uurnd-com/HeliosRGB-PIHat/Variant_SingleChannel_Rev003/Design/Schematic_Helios_PIHat_Rev_0.3.0_2026-11-04.png

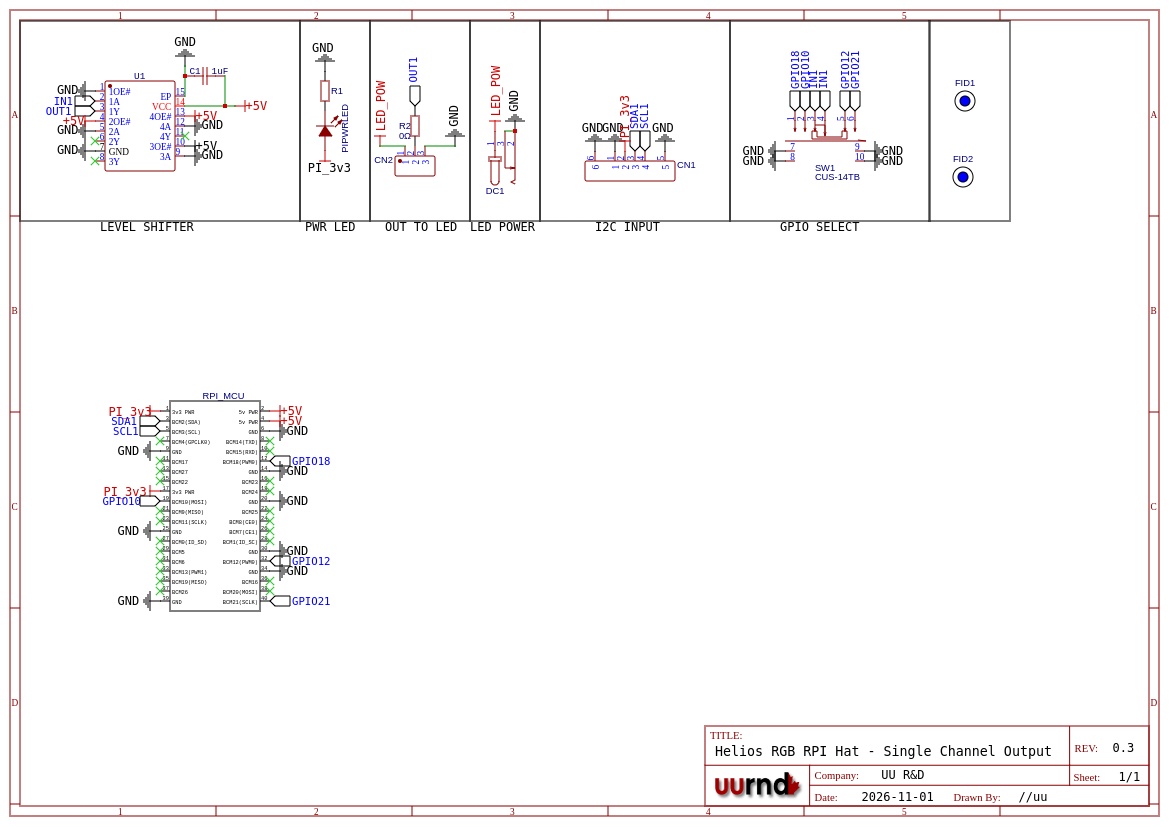
Variant_SingleChannel_Rev003/Design/Schematic_Helios_PIHat_Rev_0.3.0_2026-11-04.png
