uurnd-com/HeliosRGB-PIHat/Variant_SingleChannel_Rev003/Images/2dRenderBothSidesUnpop.png

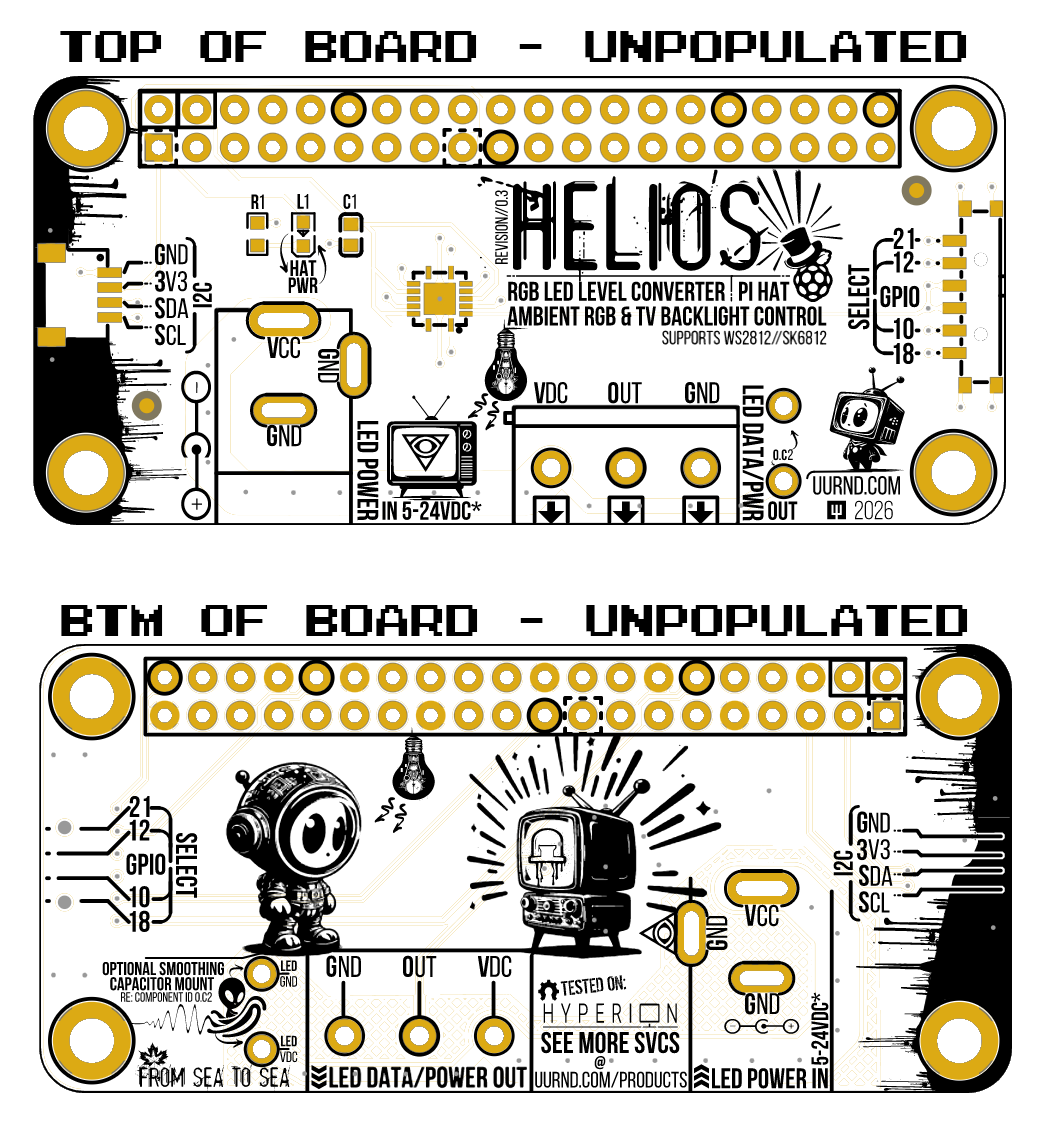
Variant_SingleChannel_Rev003/Images/2dRenderBothSidesUnpop.png
