uurnd-com/HeliosRGB-PIHat/Variant_SingleChannel_Rev003/Images/2dRenderUnpopBtm.png

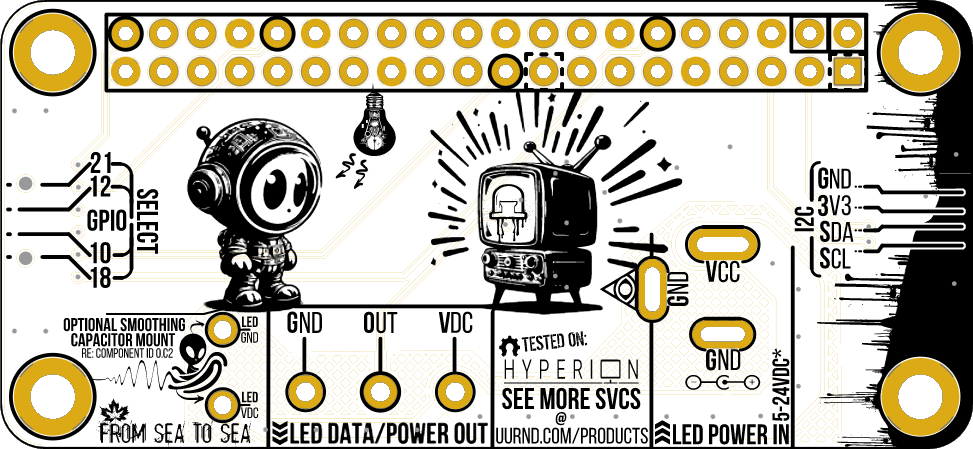
Variant_SingleChannel_Rev003/Images/2dRenderUnpopBtm.png
