uurnd-com/HeliosRGB-PIHat/Variant_SingleChannel_Rev003/Images/2dRenderUnpopTop.png

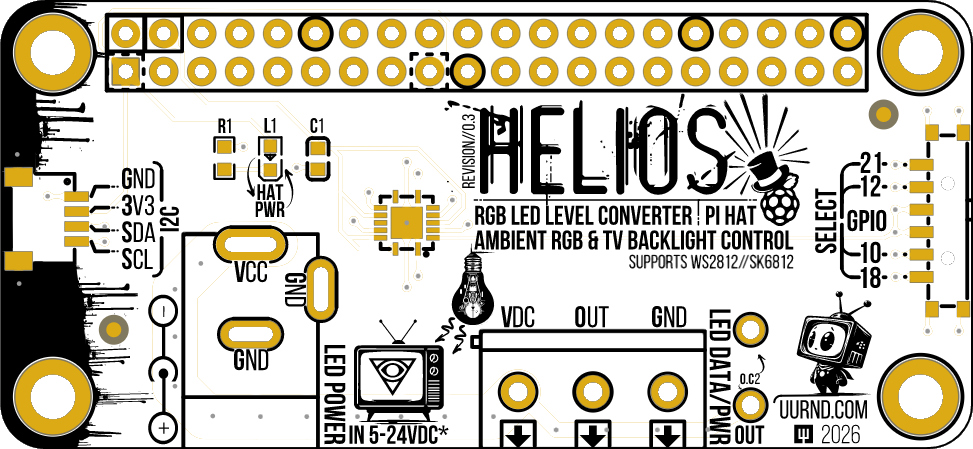
Variant_SingleChannel_Rev003/Images/2dRenderUnpopTop.png
