uurnd-com/HeliosRGB-PIHat/Variant_SingleChannel_Rev003/Images/helios-rgbled-pihat-whitebg.png

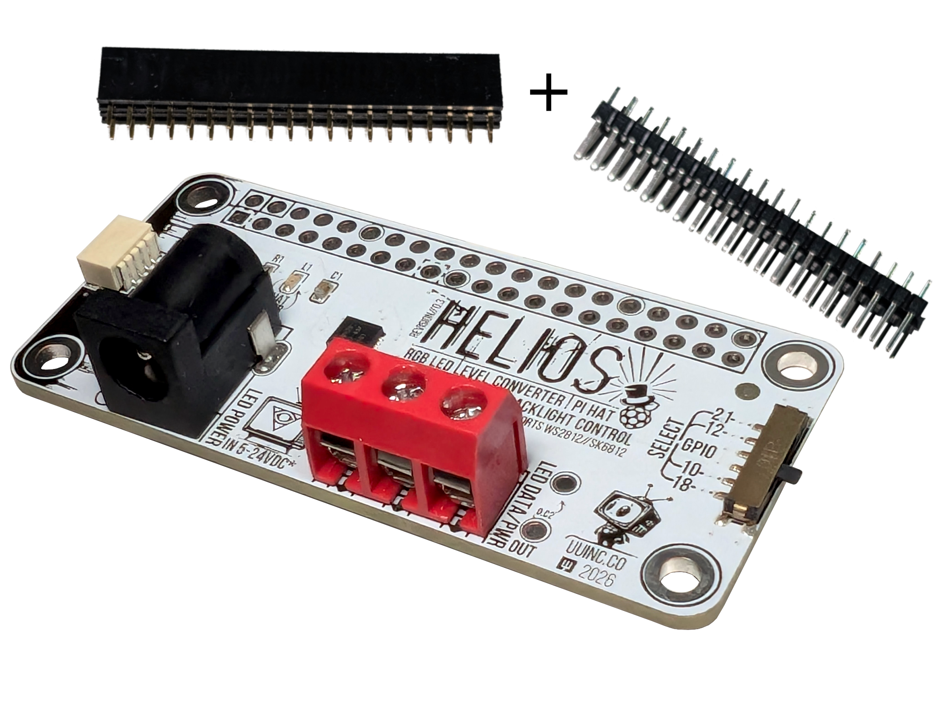
Variant_SingleChannel_Rev003/Images/helios-rgbled-pihat-whitebg.png
