uurnd-com/HeliosRGB-PIHat/Variant_SingleChannel_Rev003/Images/helios-rgbled-pihat.webp

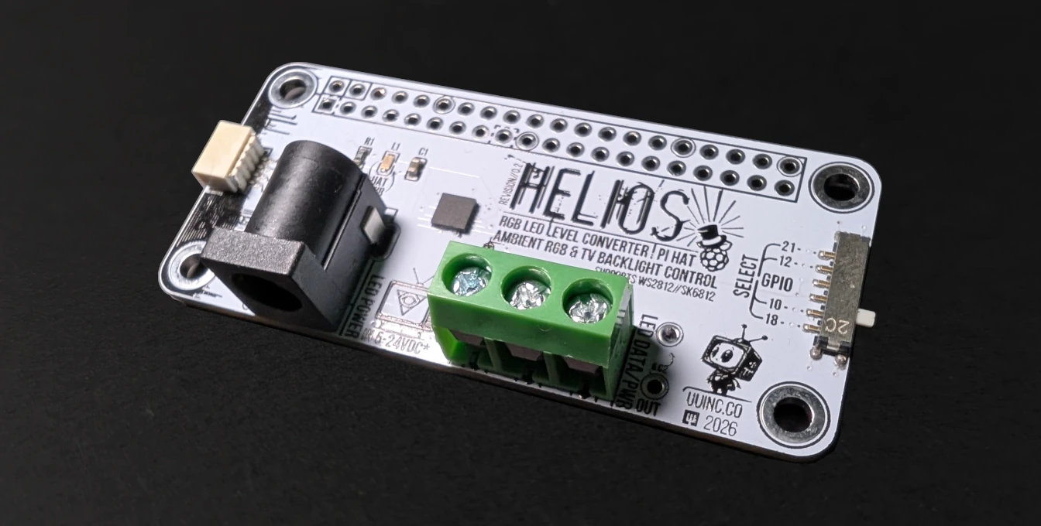
Variant_SingleChannel_Rev003/Images/helios-rgbled-pihat.webp
