uurnd-com/HeliosRGB-PIHat/Variant_SingleChannel_Rev003/3DModel/Parts/README.md

All Parts are rough-sized estimates only
