uurnd-com/HeliosRGB-PIHat/Variant_SingleChannel_Rev003/Manufacturing/BOM_Helios_PIHat_Rev_0.3.0_2026-11-04.csv

ID | Name | Designator | Footprint | Quantity | Manufacturer Part | Manufacturer | Supplier | Supplier Part | Price
1 | 1uF | 1 | C0603 | 1 | CL10A105KB8NNNC | SAMSUNG(三星) | LCSC | C15849 | 0.014
2 | TB003-500-P03BE | CN2 | UUCONN-TH_3P-P5.00_CUI_TB003-500-P03BE | 1 | TB003-500-P03BE | CUI | LCSC | C3819165 | 1.024
3 | CUS-14TB | SW1 | SW-SMD_NIDEC_CUS-14TB | 1 | CUS-14TB | NIDEC(尼得科) | LCSC | C2921741 | 0.969
4 | PJ-002AH | DC1 | DC-IN-TH_PJ-002AH | 1 | PJ-002AH | CUI | LCSC | C2961147 | 1.065
5 | 10kΩ | R1 | R0603 | 1 | 0603WAF1002T5E | UNI-ROYAL(厚声) | LCSC | C25804 | 0.002
6 | SM04B-SRSS-TB (LF)(SN) | CN1 | CONN-SMD_4P-P1.00_SM04B-SRSS-TB-LF-SN | 1 | SM04B-SRSS-TB(LF)(SN) | JST | LCSC | C160404 | 0.217
7 | KT-0603R | PIPWRLED | LED0603-RD | 1 | KT-0603R | KENTO | LCSC | C2286 | 0.008
8 | SN74AHCT125RGYR | U1 | VQFN-14_L3.5-W3.5-P0.50-BL-EP | 1 | SN74AHCT125RGYR | TI(德州仪器) | LCSC | C2675532 | 0.482
