uurnd-com/HeliosRGB-PIHat/Variant_SingleChannel_Rev003/3DModel/Cases/RPI4b_Helios_PiHatCase/RPI4_Helios_PiHatCase_Top.stl

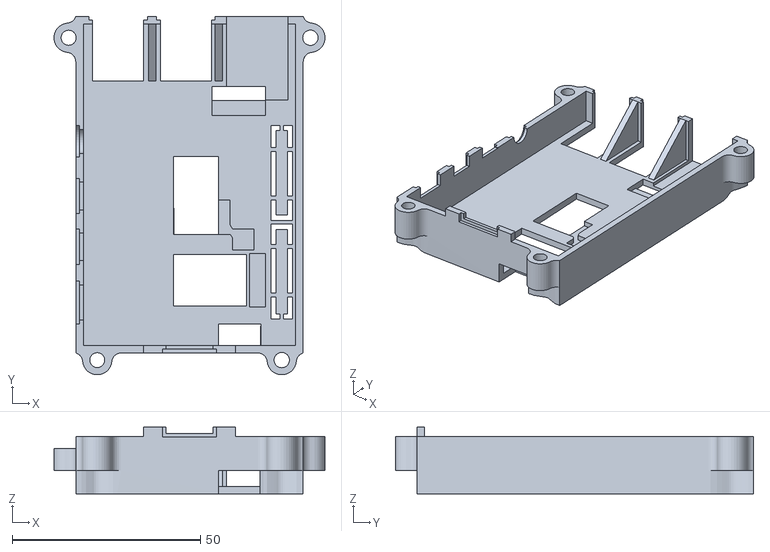
[picture p10: CAD file, 2026-11-12]
Variant_SingleChannel_Rev003/3DModel/Cases/RPI4b_Helios_PiHatCase/RPI4_Helios_PiHatCase_Top.stl
72.0 x 95.2 x 17.7
