uurnd-com/HeliosRGB-PIHat/Variant_SingleChannel_Rev003/3DModel/Cases/RPIZero_Helios_PiHatCase/HeliosPiZeroTop.stl

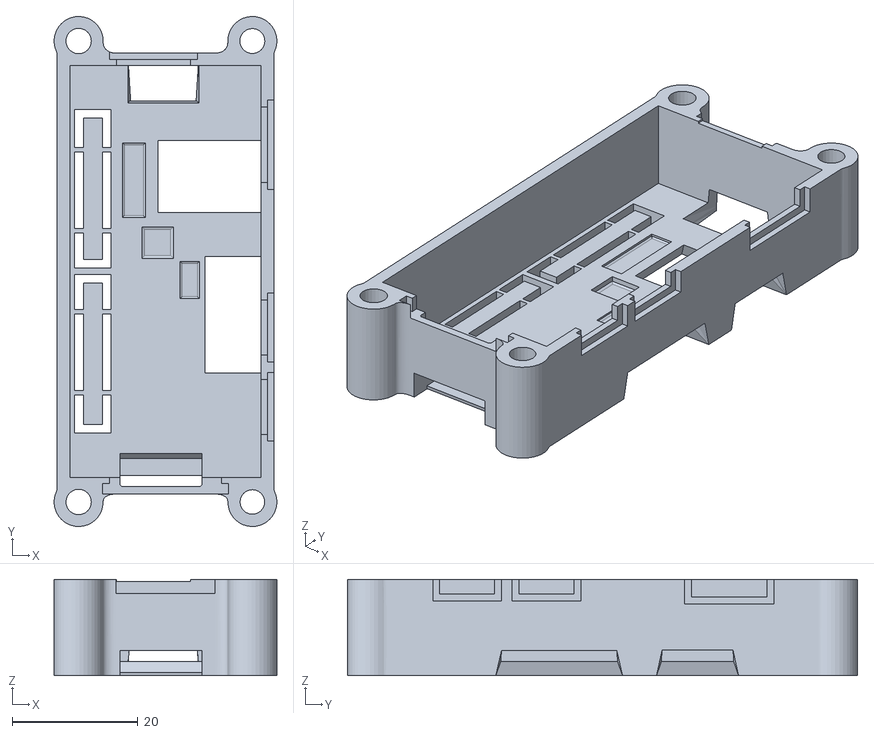
[picture p11: CAD file, 2026-11-12]
Variant_SingleChannel_Rev003/3DModel/Cases/RPIZero_Helios_PiHatCase/HeliosPiZeroTop.stl
35.4 x 81.0 x 15.3
