uurnd-com/HeliosRGB-PIHat/Variant_SingleChannel_Rev003/3DModel/MockupsAndLayouts/BoardModelPopulated/BoardModel_Populated.stl

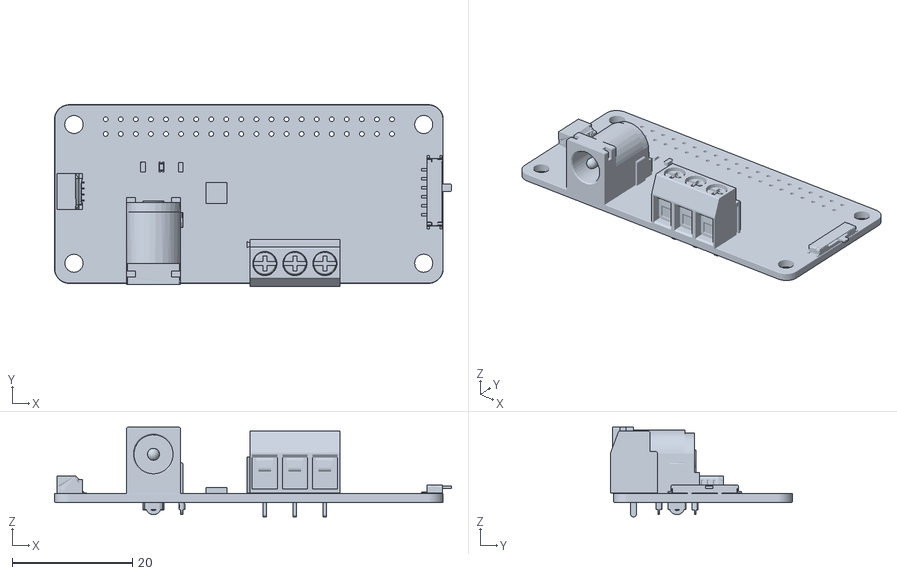
[picture p12: CAD file, 2026-11-05]
Variant_SingleChannel_Rev003/3DModel/MockupsAndLayouts/BoardModelPopulated/BoardModel_Populated.stl
66.1 x 30.3 x 14.9
