uurnd-com/HeliosRGB-PIHat/Variant_SingleChannel_Rev003/3DModel/MockupsAndLayouts/BoxModelUnpopulated/BoxModel_Unpopulated.stl

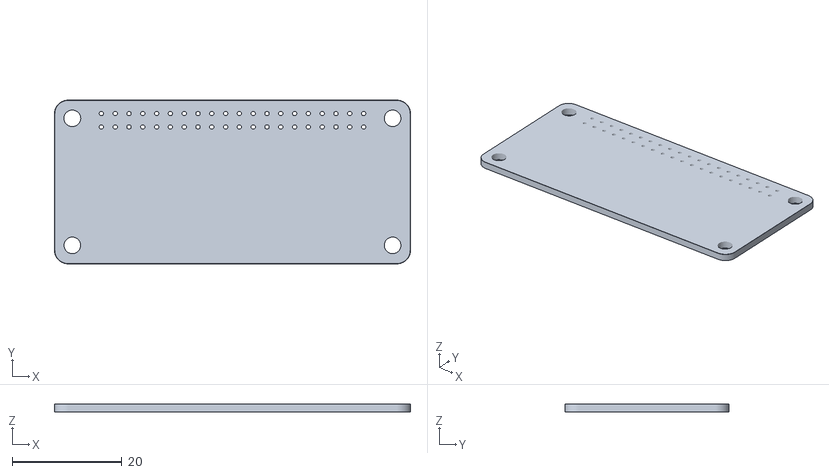
[picture p13: CAD file, 2026-11-05]
Variant_SingleChannel_Rev003/3DModel/MockupsAndLayouts/BoxModelUnpopulated/BoxModel_Unpopulated.stl
64.8 x 29.8 x 1.50
