uurnd-com/HeliosRGB-PIHat/Variant_SingleChannel_Rev003/3DModel/Parts/CUS-14TB/CUS-14TB.stl

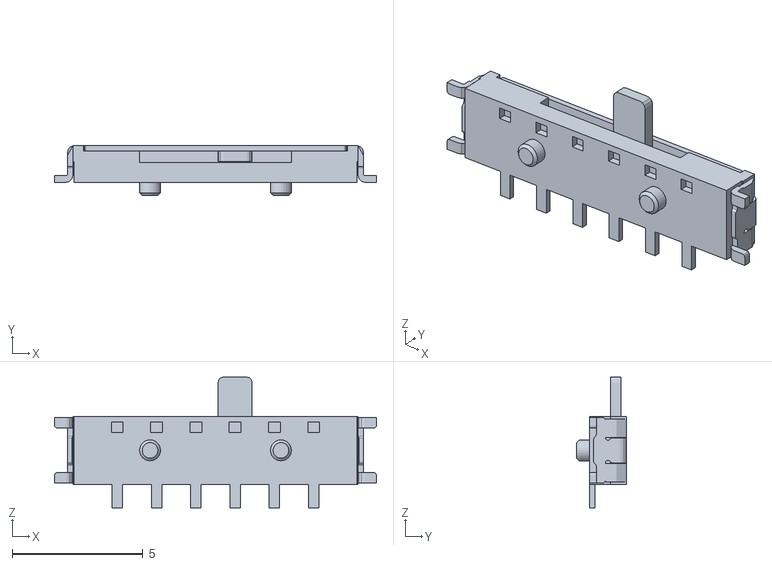
[picture p14: CAD file, 2026-01-15]
Variant_SingleChannel_Rev003/3DModel/Parts/CUS-14TB/CUS-14TB.stl
12.3 x 1.90 x 5.00
