uurnd-com/HeliosRGB-PIHat/Variant_SingleChannel_Rev003/3DModel/Parts/Passives/Passives.stl

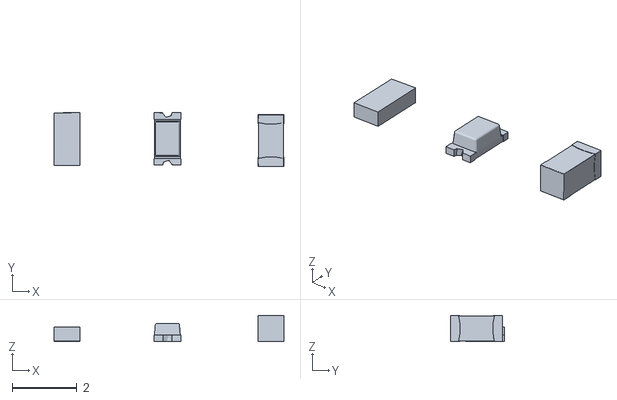
[picture p15: CAD file, 2026-11-05]
Variant_SingleChannel_Rev003/3DModel/Parts/Passives/Passives.stl
7.09 x 1.67 x 0.804
