uurnd-com/HeliosRGB-PIHat/Variant_SingleChannel_Rev003/3DModel/Parts/PJ-002AH/PJ-002AH.stl

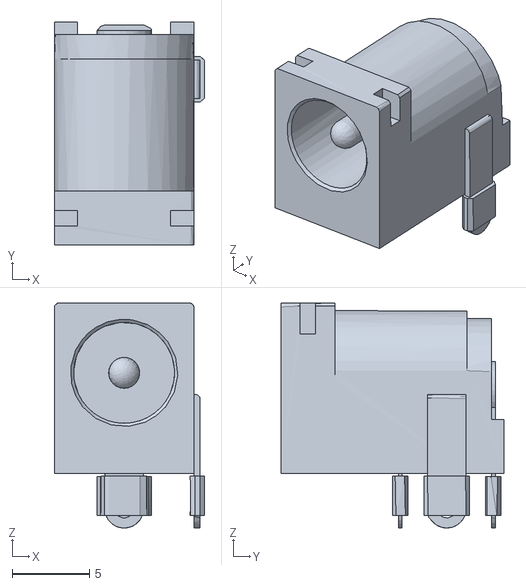
[picture p16: CAD file, 2026-11-05]
Variant_SingleChannel_Rev003/3DModel/Parts/PJ-002AH/PJ-002AH.stl
9.74 x 14.5 x 14.6
