uurnd-com/HeliosRGB-PIHat/Variant_SingleChannel_Rev003/3DModel/Parts/SM04B-SRSS-TB/SM04B-SRSS-TB.STEP

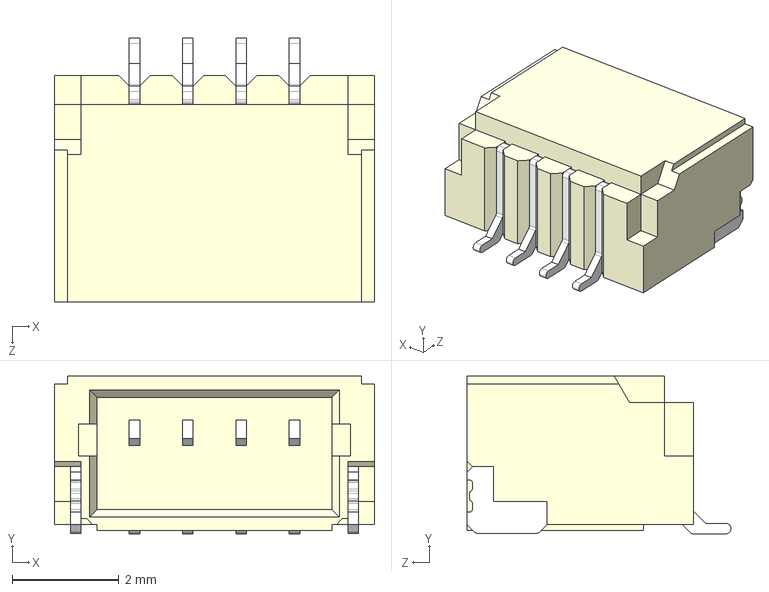
[picture p17: CAD file, 2026-01-15]
Variant_SingleChannel_Rev003/3DModel/Parts/SM04B-SRSS-TB/SM04B-SRSS-TB.STEP
6.00 x 2.96 x 4.95 mm
