uurnd-com/HeliosRGB-PIHat/Variant_SingleChannel_Rev003/3DModel/Parts/SN74AHCT125RGYR/SN74AHCT125RGYR.stl

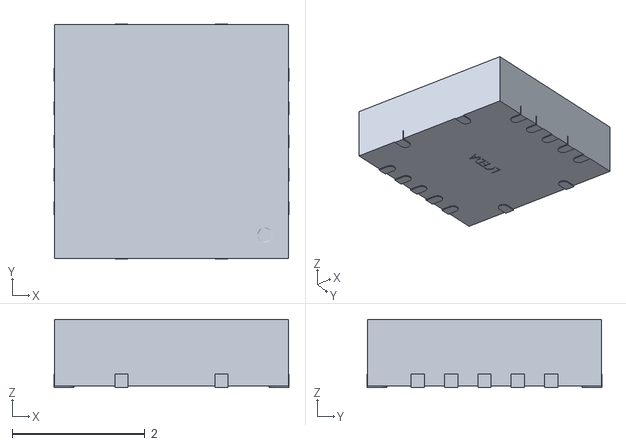
[picture p18: CAD file, 2026-11-05]
Variant_SingleChannel_Rev003/3DModel/Parts/SN74AHCT125RGYR/SN74AHCT125RGYR.stl
3.54 x 3.54 x 1.02
