uurnd-com/HeliosRGB-PIHat/Variant_SingleChannel_Rev003/3DModel/Cases/RPI4b_Helios_PiHatCase/RPI4_Helios_PiHatCase_Bottom.stl

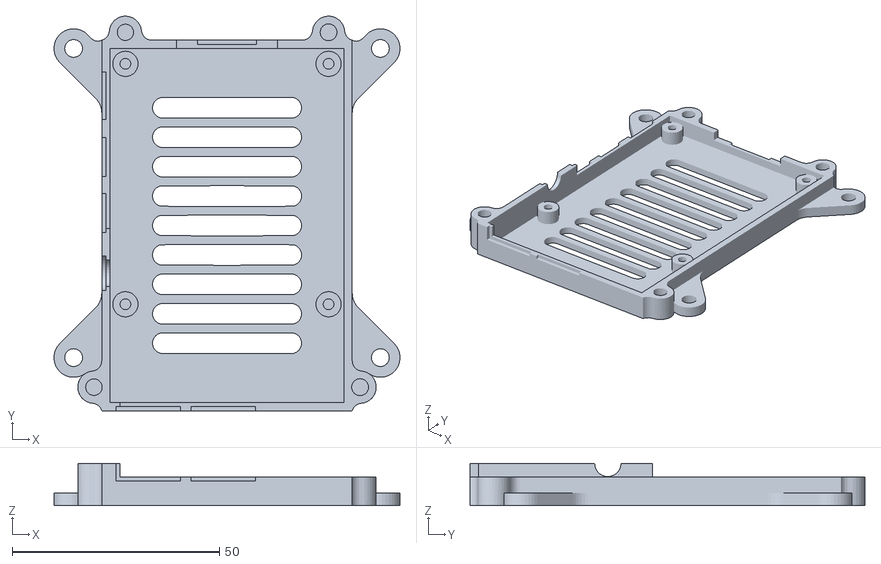
[picture p19: CAD file, 2026-11-12]
Variant_SingleChannel_Rev003/3DModel/Cases/RPI4b_Helios_PiHatCase/RPI4_Helios_PiHatCase_Bottom.stl
83.5 x 95.2 x 10.2
