uurnd-com/HeliosRGB-PIHat/Variant_SingleChannel_Rev003/3DModel/Cases/RPIZero_Helios_PiHatCase/HeliosPiZeroSupport.stl

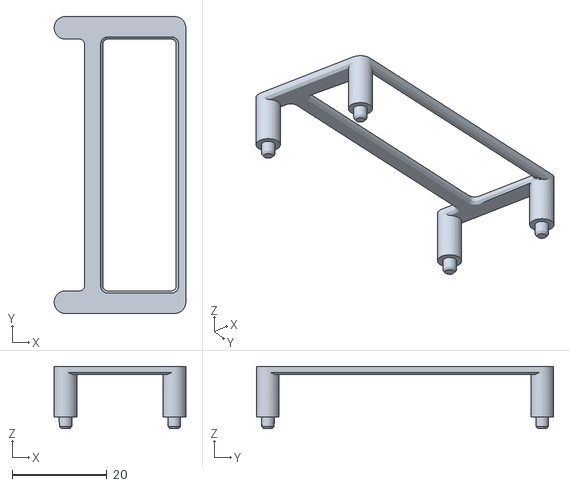
[picture p20: CAD file, 2026-11-12]
Variant_SingleChannel_Rev003/3DModel/Cases/RPIZero_Helios_PiHatCase/HeliosPiZeroSupport.stl
27.8 x 62.8 x 13.2
