uurnd-com/HeliosRGB-PIHat/Variant_SingleChannel_Rev003/3DModel/Parts/TB003-500-P03BE/Same_Sky_TB003-500-P03BE.step

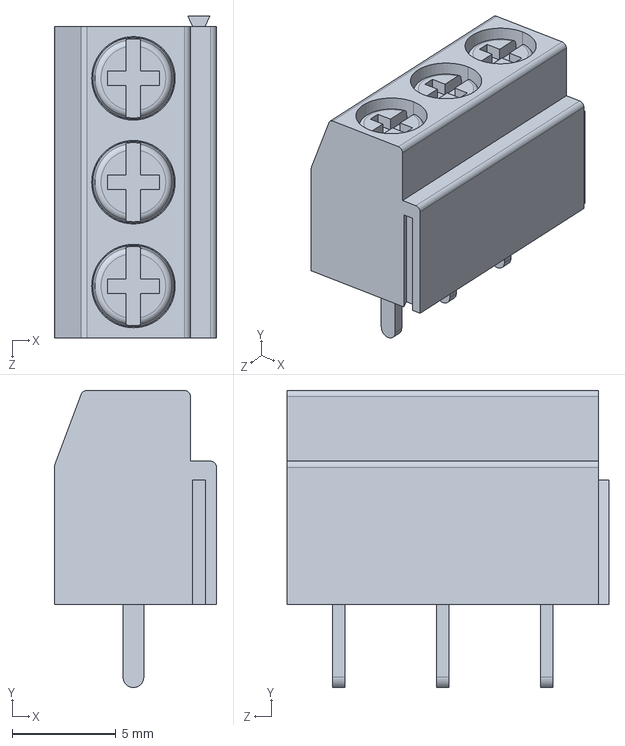
[picture p21: CAD file, 2026-01-15]
Variant_SingleChannel_Rev003/3DModel/Parts/TB003-500-P03BE/Same_Sky_TB003-500-P03BE.step
7.80 x 14.3 x 15.5 mm
