uurnd-com/HeliosRGB-PIHat/Variant_SingleChannel_Rev003/3DModel/Cases/RPI4b_Helios_PiHatCase/RPI4_Helios_PiHatCase_Support.stl

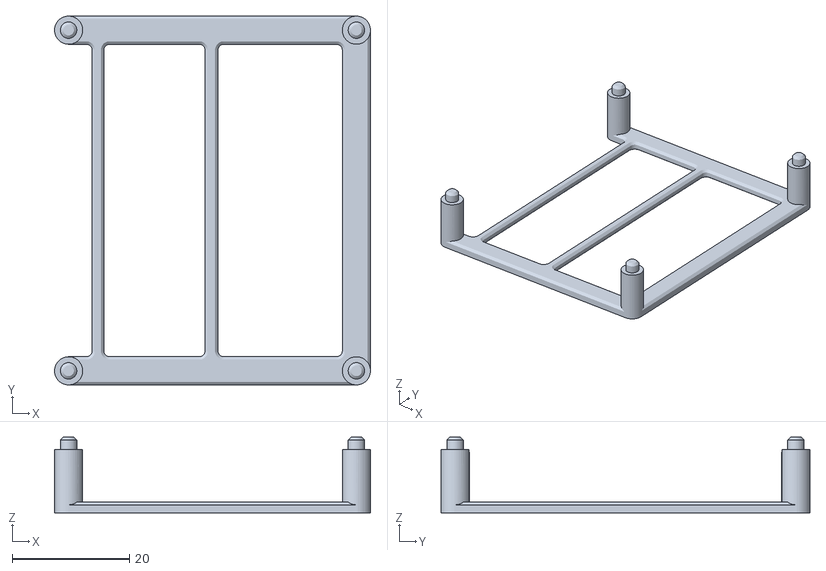
[picture p22: CAD file, 2026-11-12]
Variant_SingleChannel_Rev003/3DModel/Cases/RPI4b_Helios_PiHatCase/RPI4_Helios_PiHatCase_Support.stl
53.8 x 62.8 x 12.9
