uurnd-com/HeliosRGB-PIHat/Variant_SingleChannel_Rev003/3DModel/Cases/RPIZero_Helios_PiHatCase/HeliosPiZeroBottomLogo.stl

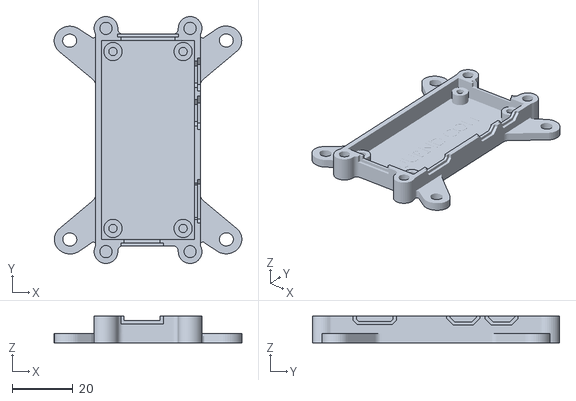
[picture p23: CAD file, 2026-11-12]
Variant_SingleChannel_Rev003/3DModel/Cases/RPIZero_Helios_PiHatCase/HeliosPiZeroBottomLogo.stl
61.5 x 81.0 x 8.70
