uurnd-com/HeliosRGB-PIHat/(list of files, cad)

Other CAD files:
Variant_SingleChannel_Rev003/3DModel/Parts/TB003-500-P03BE/Same_Sky_TB003-500-03P(Blue - P).SLDPRT
Variant_SingleChannel_Rev003/3DModel/Cases/RPIZero_Helios_PiHatCase/HeliosPiZeroBottom.stl
Variant_SingleChannel_Rev003/3DModel/Cases/RPIZero_Helios_PiHatCase/HeliosPiZeroBottom.obj
Variant_SingleChannel_Rev003/3DModel/Cases/RPIZero_Helios_PiHatCase/HeliosPiZeroBottomLogo.obj
Variant_SingleChannel_Rev003/3DModel/Cases/RPIZero_Helios_PiHatCase/HeliosPiZeroSupport.obj
Variant_SingleChannel_Rev003/3DModel/Cases/RPIZero_Helios_PiHatCase/HeliosPiZeroTop.obj
Variant_SingleChannel_Rev003/3DModel/Parts/CUS-14TB/CUS-14TB.obj
Variant_SingleChannel_Rev003/3DModel/Parts/SM04B-SRSS-TB/SM04B-SRSS-TB.stl
Variant_SingleChannel_Rev003/3DModel/Parts/TB003-500-P03BE/Same_Sky_TB003-500-P03BE.STL
