uurnd-com/HeliosRGB-PIHat/Variant_SingleChannel_Rev003/Information/ConnectionGuide/RaspberryPiConnectionGuide5VDC-24VDC.pdf

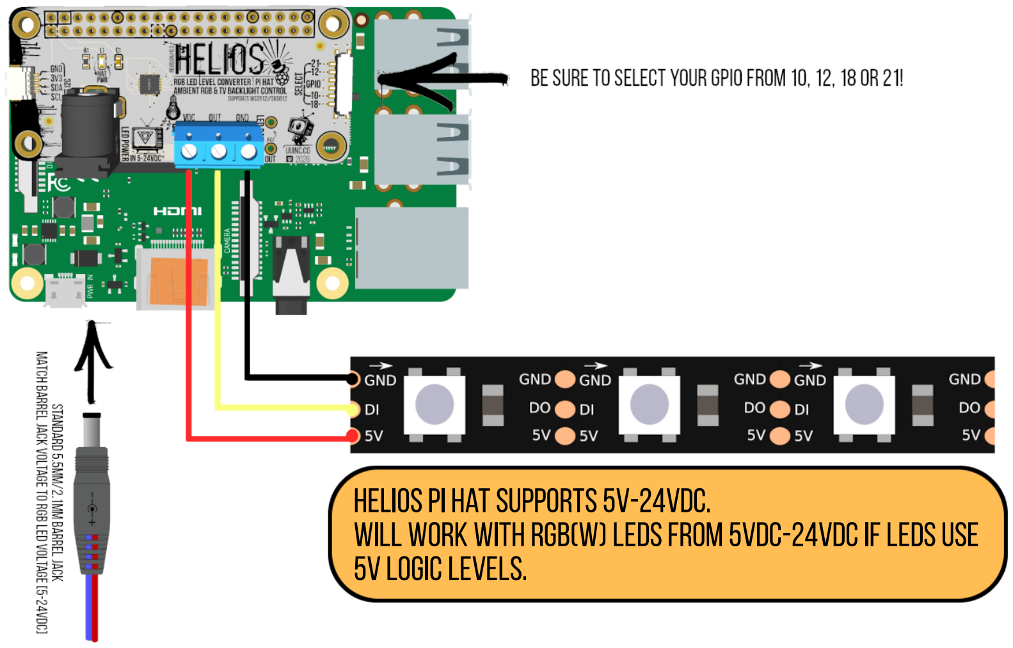
[picture p24: page 1]

Helios Pi Hat Supports 5V-24VDC.
Will work with RGB(W) LEDs from 5VDC-24VDC if LEDs use 5V Logic Levels.
