uurnd-com/HeliosRGB-PIHat/Variant_SingleChannel_Rev003/Information/pinout_guide.pdf

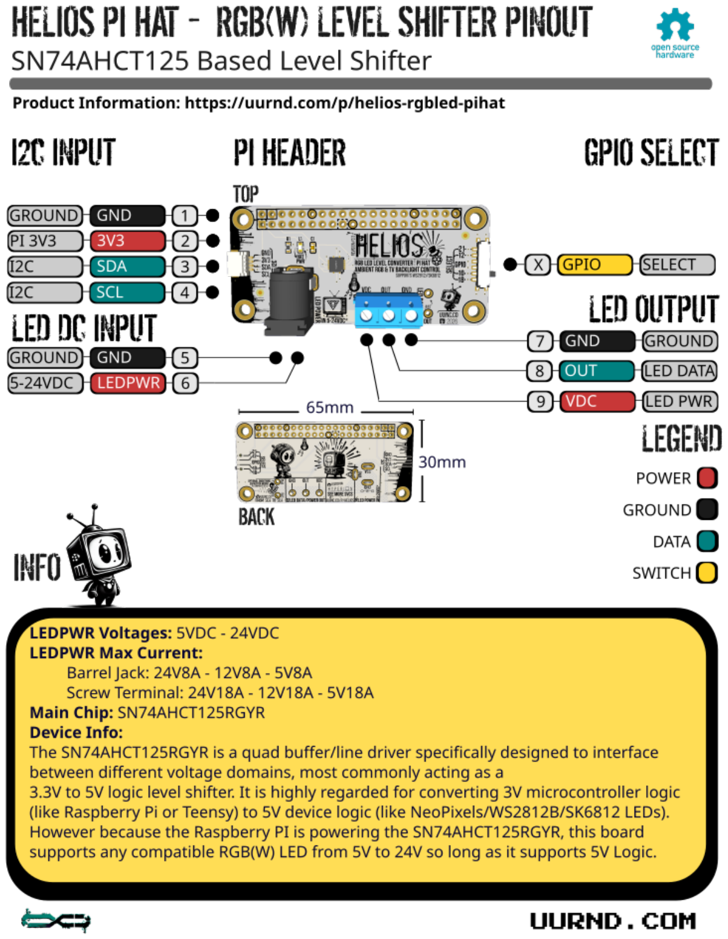
[picture p25: page 1]
