uurnd-com/HeliosRGB-PIHat/Variant_SingleChannel_Rev003/Information/pinout_lite_guide.pdf

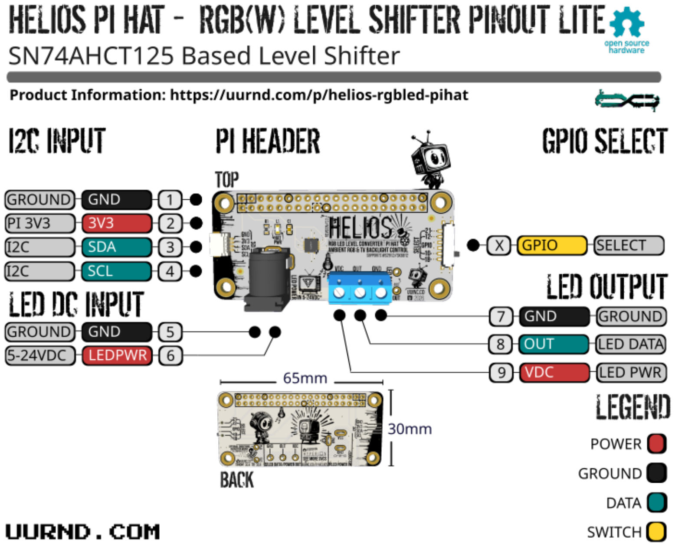
[picture p26: page 1]
