uurnd-com/HeliosRGB-PIHat/Variant_SingleChannel_Rev003/Information/ConnectionGuide/RaspberryPiConnectionGuide.pdf

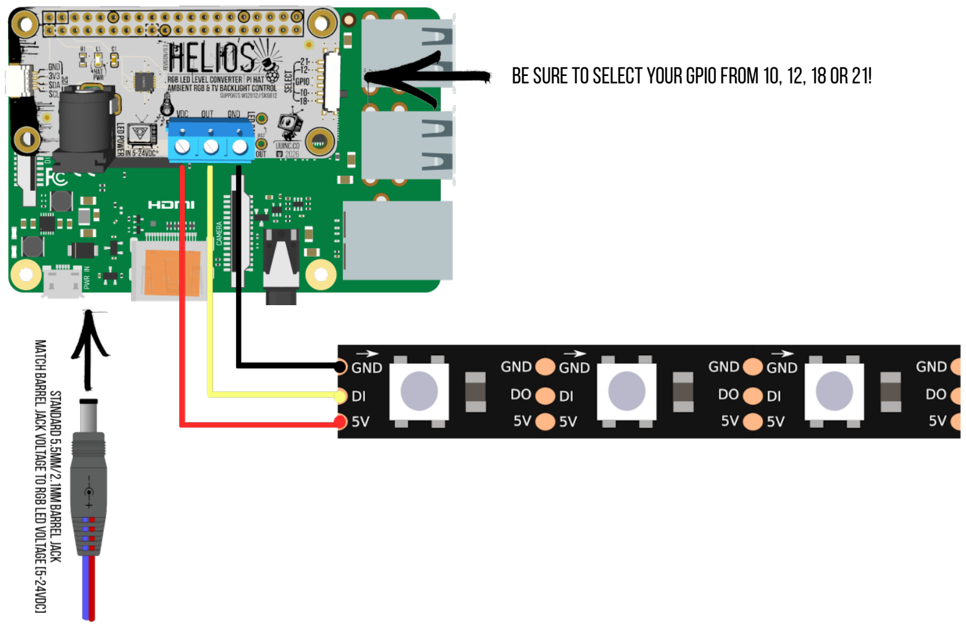
[picture p27: page 1]

Be sure to select your GPIO from 10, 12, 18 or 21!
