uurnd-com/HeliosRGB-PIHat/Variant_SingleChannel_Rev003/Information/ConnectionGuide/RaspberryPiZero_ZeroWConnectionGuide_5VDC-24VDC.jpg

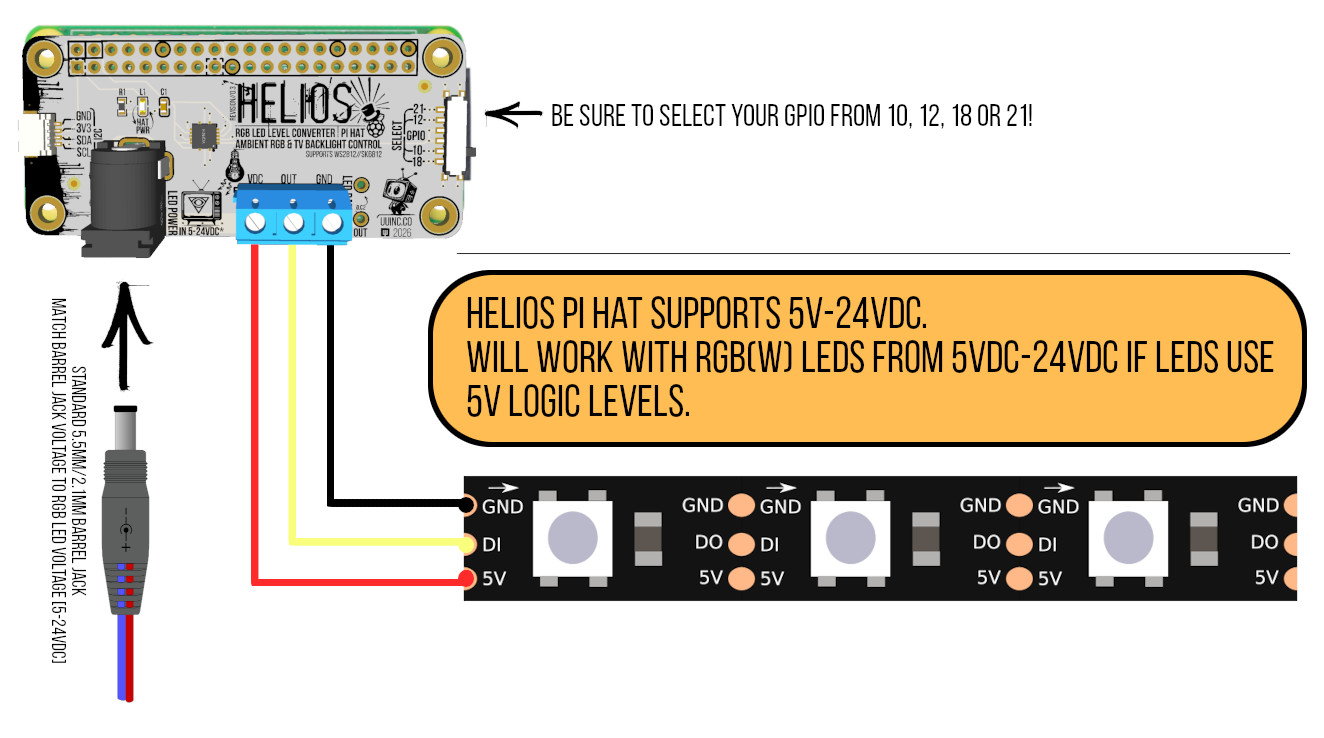
Variant_SingleChannel_Rev003/Information/ConnectionGuide/RaspberryPiZero_ZeroWConnectionGuide_5VDC-24VDC.jpg
