uurnd-com/HeliosRGB-PIHat/Variant_SingleChannel_Rev003/Information/pinout_lite_guide.png

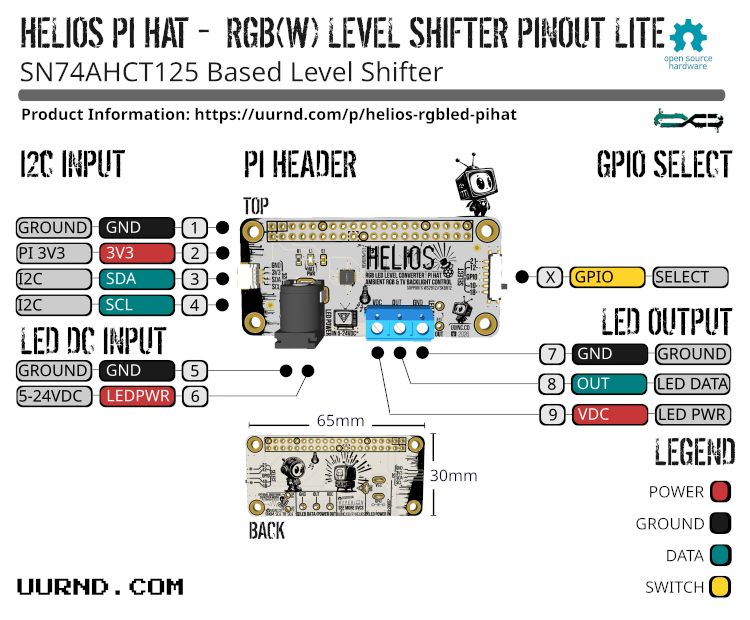
Variant_SingleChannel_Rev003/Information/pinout_lite_guide.png
