uurnd-com/HeliosRGB-PIHat/Variant_SingleChannel_Rev003/Design/BTM_PCB_Helios_PIHat_Rev_0.3.0_2026-11-04.pdf

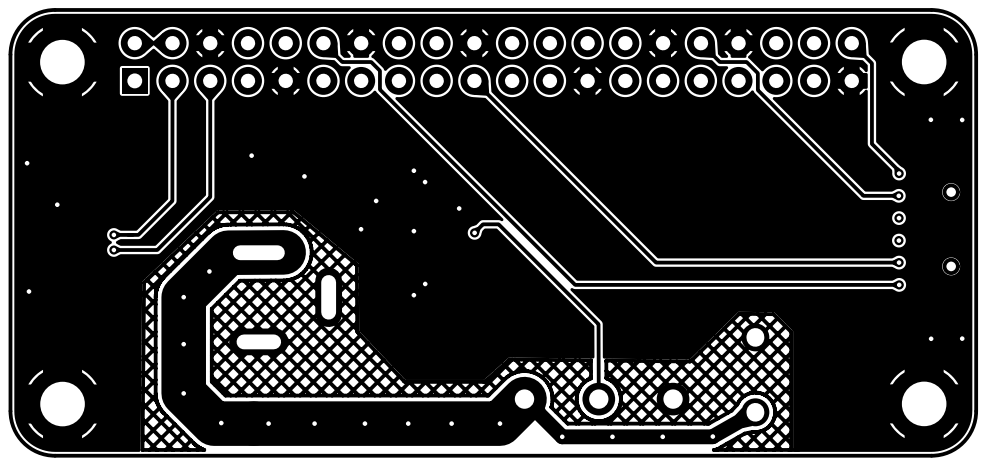
[picture p32: page 1]
