uurnd-com/HeliosRGB-PIHat/Variant_SingleChannel_Rev003/Design/TOP_PCB_Helios_PIHat_Rev_0.3.0_2026-11-04.pdf

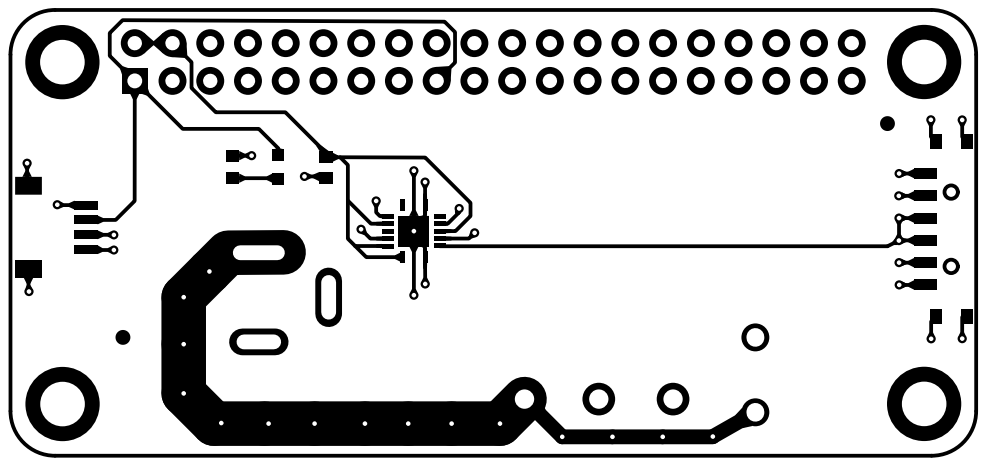
[picture p33: page 1]
