uurnd-com/HeliosRGB-PIHat/Variant_SingleChannel_Rev002/Design/Schematic/Schematic_PCB_Helios_V0.2_2026-01-15.pdf

A | A

1

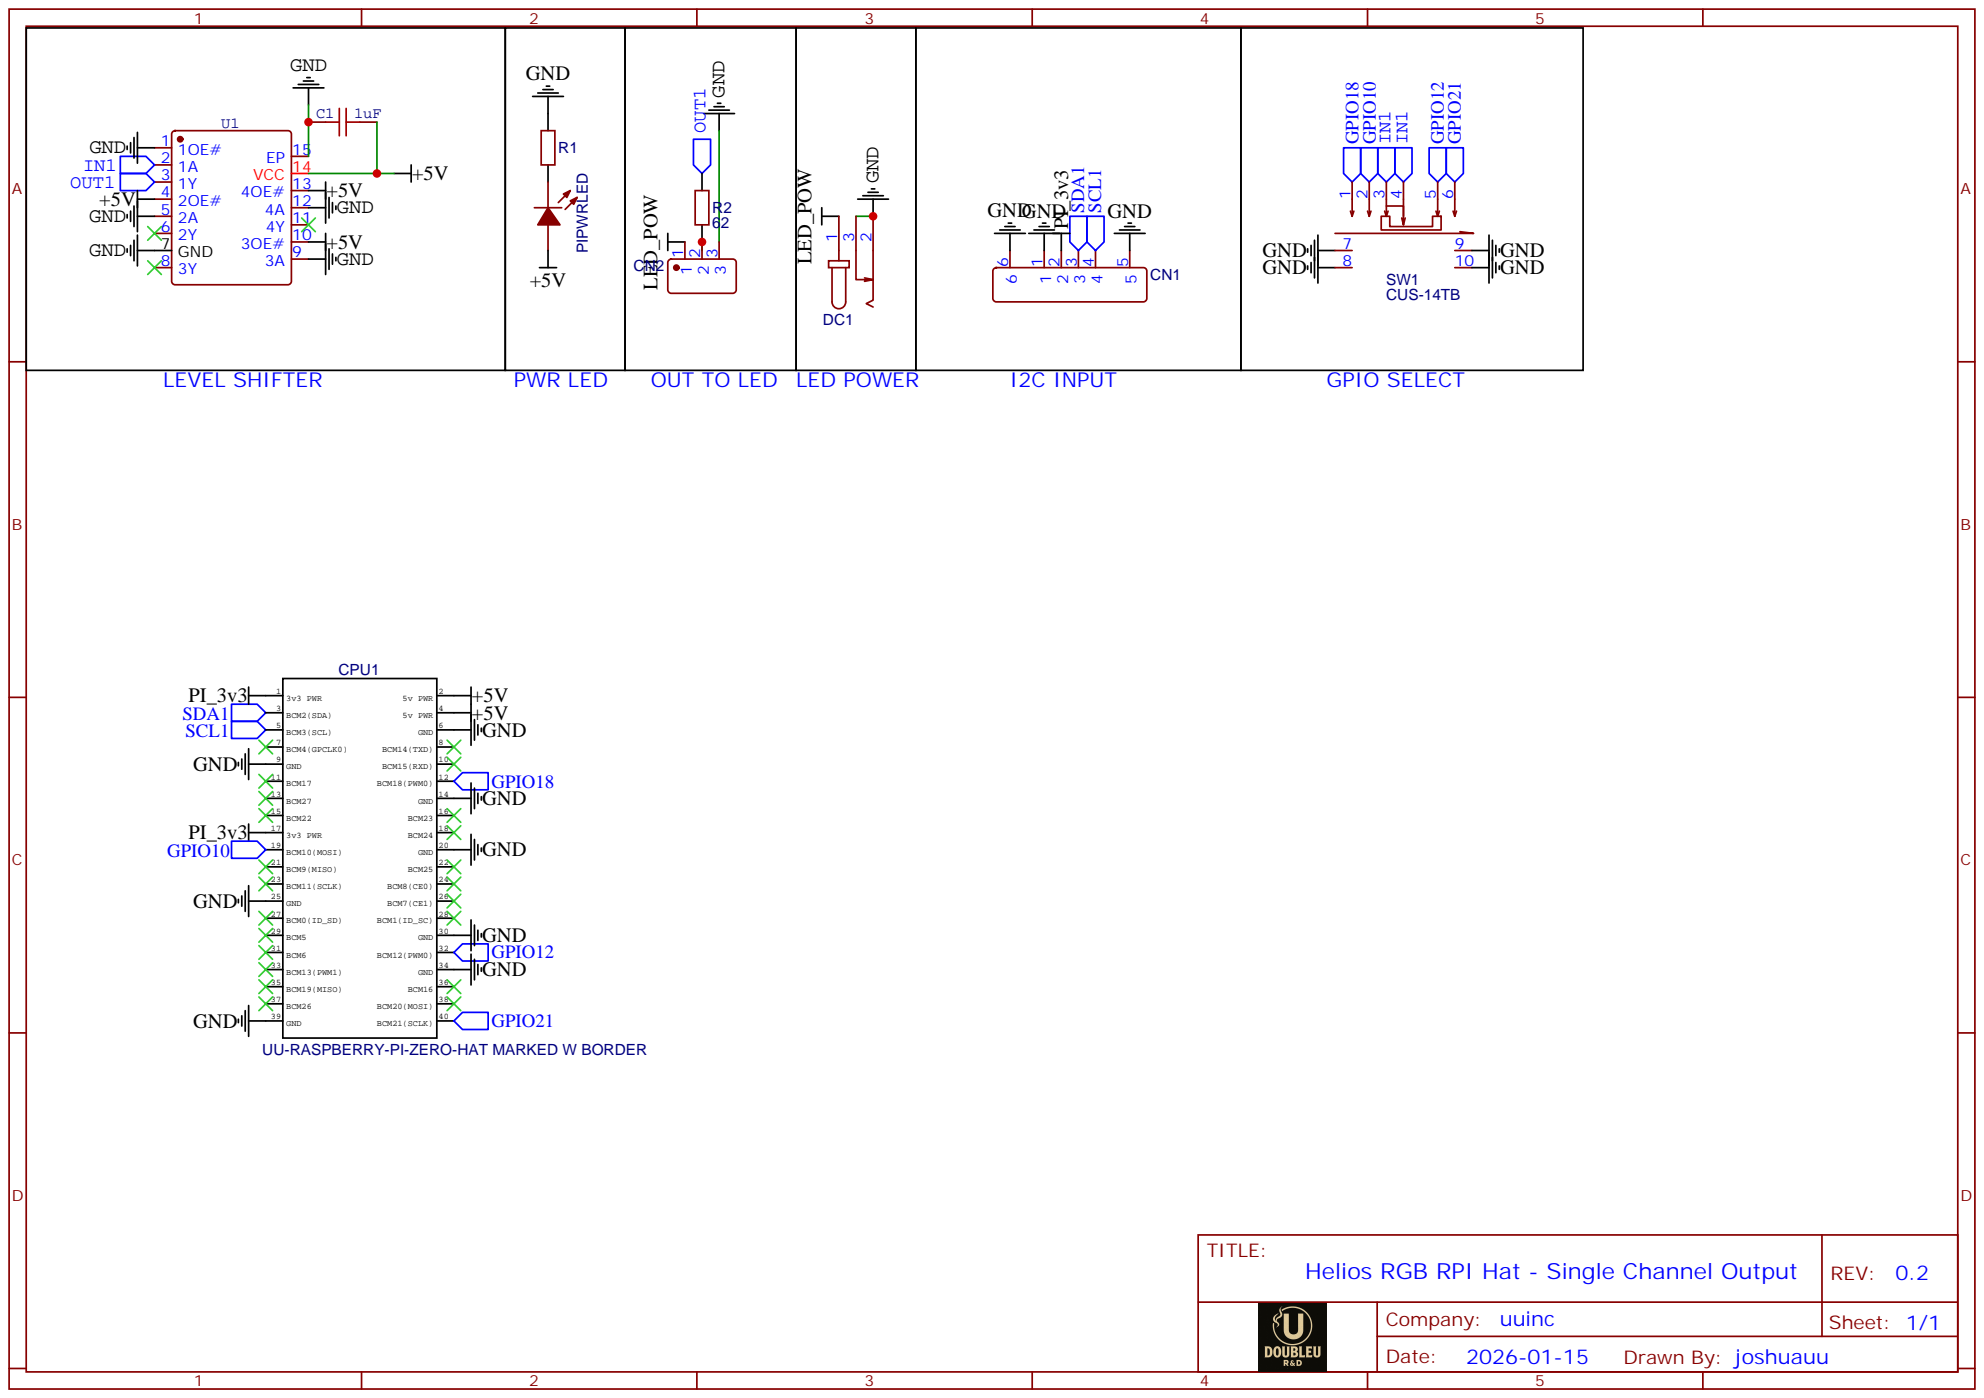
[picture p35: page 1]
