uurnd-com/HeliosRGB-PIHat/(list of files, drawings)

Other design files:
Variant_SingleChannel_Rev002/Design/Schematic/Altium/Sheet_1_2026-01-15.schdoc
