uurnd-com/HeliosRGB-PIHat/(commit log)

2025-11-14 Quick build
    [BOM_Raspberry-PI-LED_2025-11-13.csv, PickAndPlace_Helios_V0.2B_2025-11-13.csv, SCH_Raspberry-PI-LED_2025-11-13.json, Sheet_1_2025-11-13.schdoc]
2025-11-14 wrong place
    [SCH_Raspberry-PI-LED_2025-11-13.json]
2025-11-14 Moved to version bin
    [BOM_Raspberry-PI-LED_2025-11-13.csv, PickAndPlace_Helios_V0.2B_2025-11-13.csv, SCH_Raspberry-PI-LED_2025-11-13.json, Sheet_1_2025-11-13.schdoc]
2026-01-15 Updated with actual model sent to pcb producer
    [BOM_Raspberry-PI-Hat-RGBLED_2026-01-15.csv, BOM_Raspberry-PI-LED_2025-11-13.csv, PickAndPlace_Helios_V0.2B_2025-11-13.csv, PickAndPlace_Raspberry-PI-Hat-RGBLED_2026-01-15.csv, SCH_EASYEDA_Helios_V0.2_2026-01-15.json, SCH_Raspberry-PI-LED_2025-11-13.json, Sheet_1_2025-11-13.schdoc, Sheet_1_2026-01-15.schdoc]
2026-01-15 Added Models of Most PArts
    [CUS-14TB.obj, CUS-14TB.stl, SM04B-SRSS-TB.STEP, Same_Sky_TB003-500-03P(Blue - P).SLDPRT, Same_Sky_TB003-500-P03BE.STL, Same_Sky_TB003-500-P03BE.step]
2026-01-15 Changed folder structure to match others
    [BOM_Raspberry-PI-Hat-RGBLED_2026-01-15.csv, CUS-14TB.obj, CUS-14TB.stl, PickAndPlace_Raspberry-PI-Hat-RGBLED_2026-01-15.csv, SCH_EASYEDA_Helios_V0.2_2026-01-15.json, SM04B-SRSS-TB.STEP, Same_Sky_TB003-500-03P(Blue - P).SLDPRT, Same_Sky_TB003-500-P03BE.STL]
2026-02-08 Swapped 62ohm w/ 0ohm, issues with reliability with newer 745s
    [BOM_Helios_PI_Rev_0_2_1_2026-02-08.csv, BOM_Raspberry-PI-Hat-RGBLED_2026-01-15.csv, PickAndPlace_PCB_HeliosRGB_RPI5-RPIZero_RGBHAT_SingleChannel_2026-02-08.csv, PickAndPlace_Raspberry-PI-Hat-RGBLED_2026-01-15.csv, SCH_EASYEDA_Helios_V0.2_2026-01-15.json, SCH_Helios_PI_Rev_0_2_1_2026-02-08.json, Sheet_1_2026-02-08.schdoc]
2026-02-08 Updated, added rev3
    [BOM_Raspberry-PI-Hat-RGBLED_2026-01-15.csv, CUS-14TB.obj, CUS-14TB.stl, PickAndPlace_Raspberry-PI-Hat-RGBLED_2026-01-15.csv, SCHEMA_Helios_PIHAT_Rev.0.3.0_2026-02-08.schdoc, SCH_Helios_PIHat_Rev_0.3.0_2026-02-08.json, SM04B-SRSS-TB.STEP, Same_Sky_TB003-500-03P(Blue - P).SLDPRT]
2026-02-12 readme and 2.2 revision build
    [BOM_Helios_PI_Rev_0_2_1_2026-02-12.csv, PickAndPlace_PCB_HeliosRGB_RPI5-RPIZero_RGBHAT_SingleChannel_2026-02-12.csv]
2026-04-10 ADded Gitignore
    [BOM_Raspberry-PI-Hat-RGBLED_2026-01-15.csv, CUS-14TB.obj, CUS-14TB.stl, PickAndPlace_Raspberry-PI-Hat-RGBLED_2026-01-15.csv, SCHEMA_Helios_PIHAT_Rev.0.3.0_2026-02-08.schdoc, SCH_Helios_PIHat_Rev_0.3.0_2026-02-08.json, SM04B-SRSS-TB.STEP, Same_Sky_TB003-500-03P(Blue - P).SLDPRT]
2026-04-11 Repo (Normalization)
    [BOM_Helios_PI_Rev_0_2_1_2026-02-08.csv, PickAndPlace_PCB_HeliosRGB_RPI5-RPIZero_RGBHAT_SingleChannel_2026-02-08.csv, SCH_Helios_PI_Rev_0_2_1_2026-02-08.json, Sheet_1_2026-02-08.schdoc]
2026-11-05 Added PCB Layout
2026-11-12 Added Case // Needs Attribution and Images
    [HeliosPiZeroBottom.obj, HeliosPiZeroBottom.stl, HeliosPiZeroBottomLogo.obj, HeliosPiZeroBottomLogo.stl, HeliosPiZeroSupport.obj, HeliosPiZeroSupport.stl, HeliosPiZeroTop.obj, HeliosPiZeroTop.stl]
2026-11-12 added attribution
    [RPI4_Helios_PiHatCase_Bottom.stl, RPI4_Helios_PiHatCase_Support.stl, RPI4_Helios_PiHatCase_Top.stl]
